TranHieu024/EOS/HTN_nhom15/Readme.md

# Đề tài máy đo huyết áp thông minh esp32

Project github bao gồm:
* File code .ino trong thư mục Esp_blood
* File PCB gồm sch và pcb 
* 2 file pdf quyển báo cáo và slides báo cáo

>> Nhóm 15 - Đồ án Thiết kế Hệ Thống Nhúng 
>> Giảng viên hướng dẫn: Ths. Lương Công Duẩn
