TranHieu024/EOS/W2/bt.md

# NHÓM 2 BÁO CÁO BÀI TẬP TUẦN 2

## CÔNG VIỆC ĐÃ LÀM: 

- Biên dịch và cài đặt uboot
- Biên dịch và cài đặt Kernel

## Chi tiết:

- Biên dịch ra các file cho uboot, MLO, zimage và boneblack.dtb

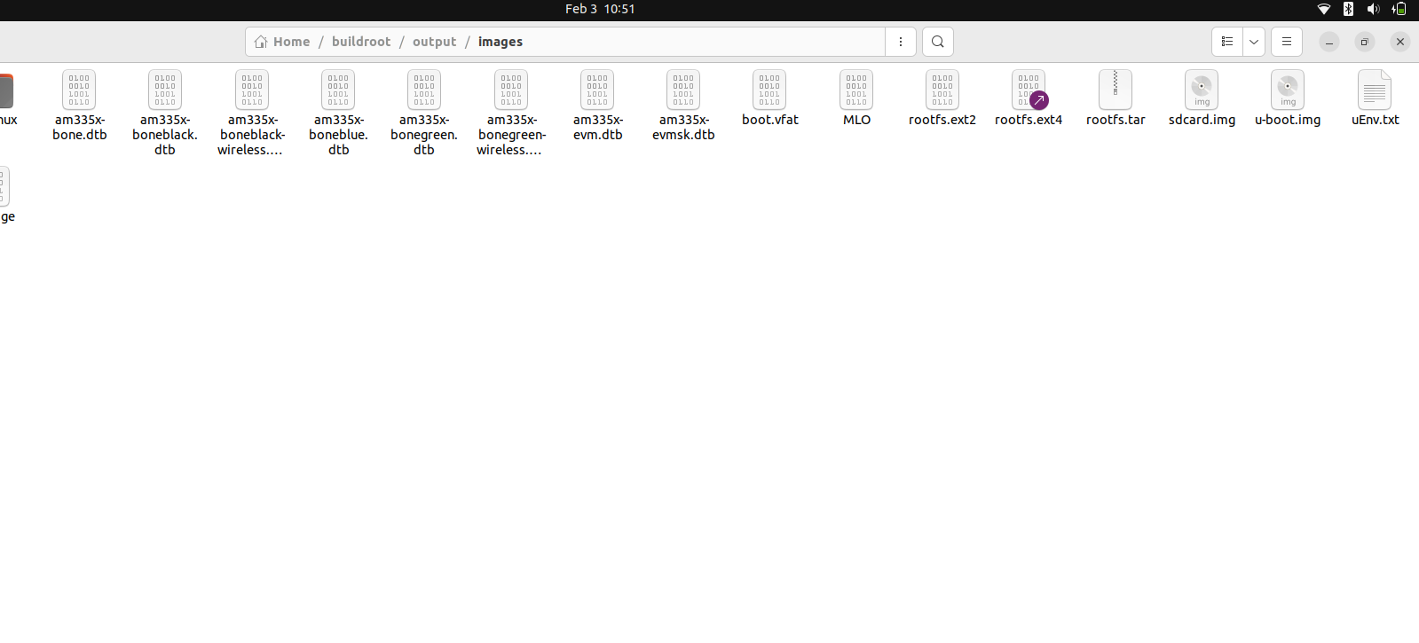
[picture p19: W2/files.png]
  
  
- Load được vào uboot, hiển thị tt phần cứng, uboot version và phản hồi với các lệnh

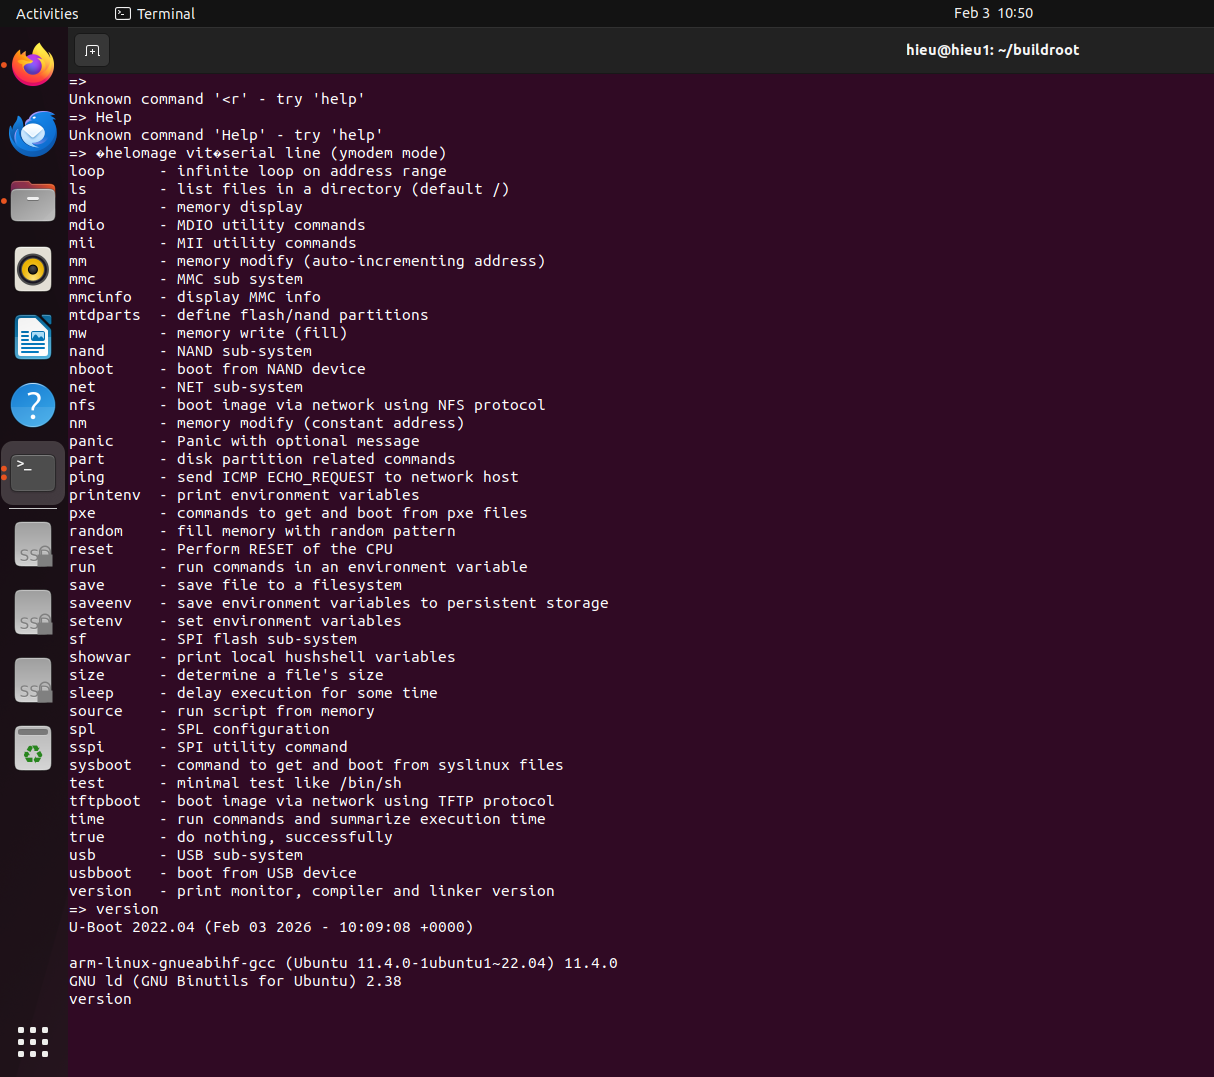
[picture p20: W2/ubootlenh.png]
  
 
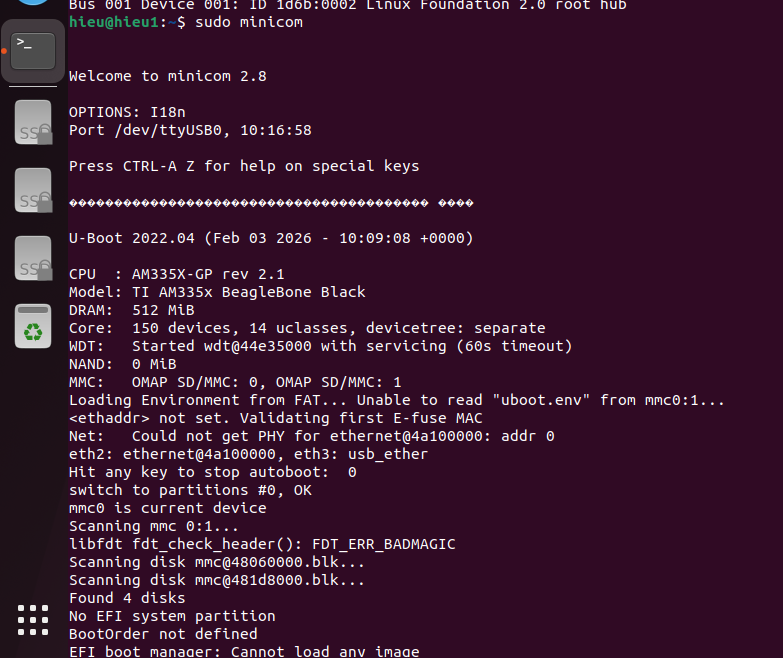
[picture p21: W2/hard.png]
  
  
- Nạp file image, load vào Kernel

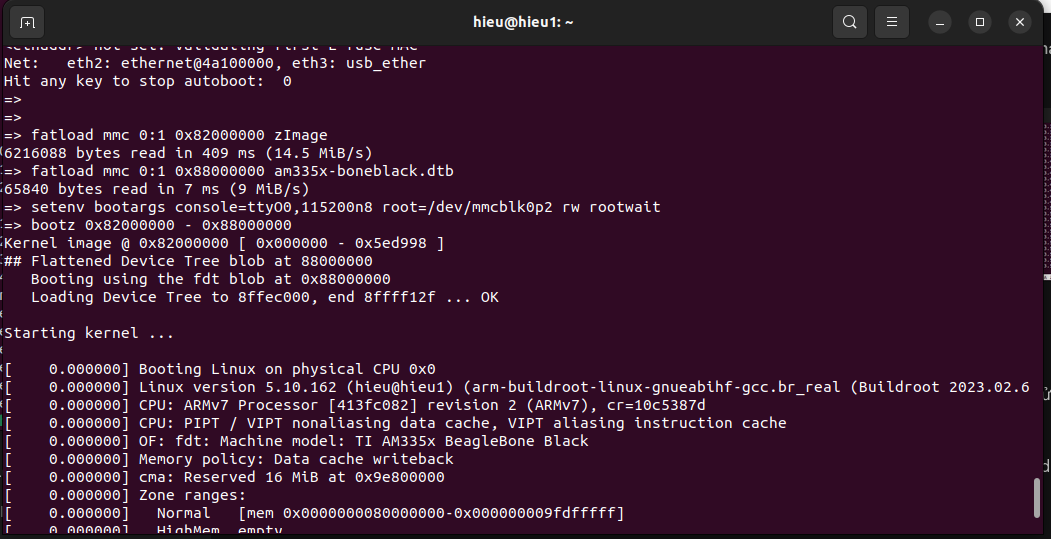
[picture p22: W2/kernelstart.png]
  
 
- Đợi root

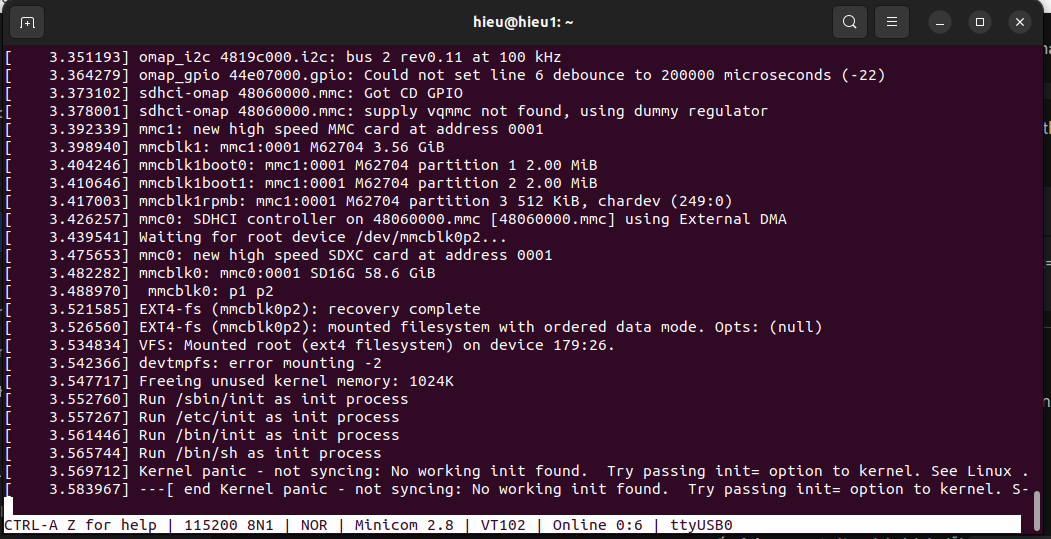
[picture p23: W2/kernelend.png]
  

# BÀI TẬP TUẦN 3

## Công việc đã làm: 

- Khởi động rootfs chạy các lệnh ls, cat, echo
- Chạy lệnh vi

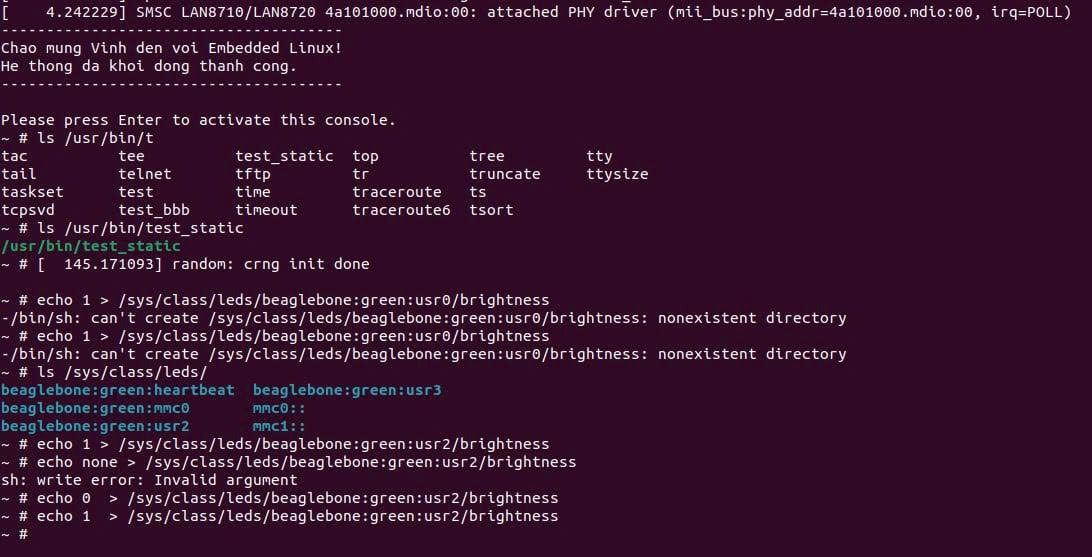
[picture p24: W2/w3_1.png]
  
  
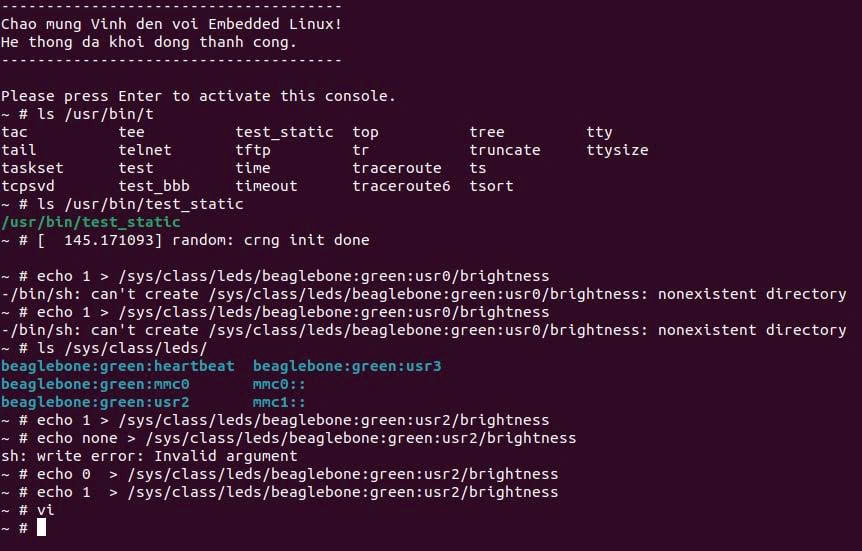
[picture p25: W2/w3_2.png]
