TranHieu024/EOS/(list of files, drawings)

Other design files:
HTN_nhom15/PCB/final_modue.PcbDoc
HTN_nhom15/PCB/Sheet2.SchDoc
