TranHieu024/EOS/(commit log)

2026-02-24 tuần 3
2026-05-24 update báo cáo
    [Sheet2.SchDoc, final_modue.PcbDoc]
